karthik-k-bhat/Ultrasonic-Data-Transfer/Images/Dog_repellant_circuit_simulation.JPG

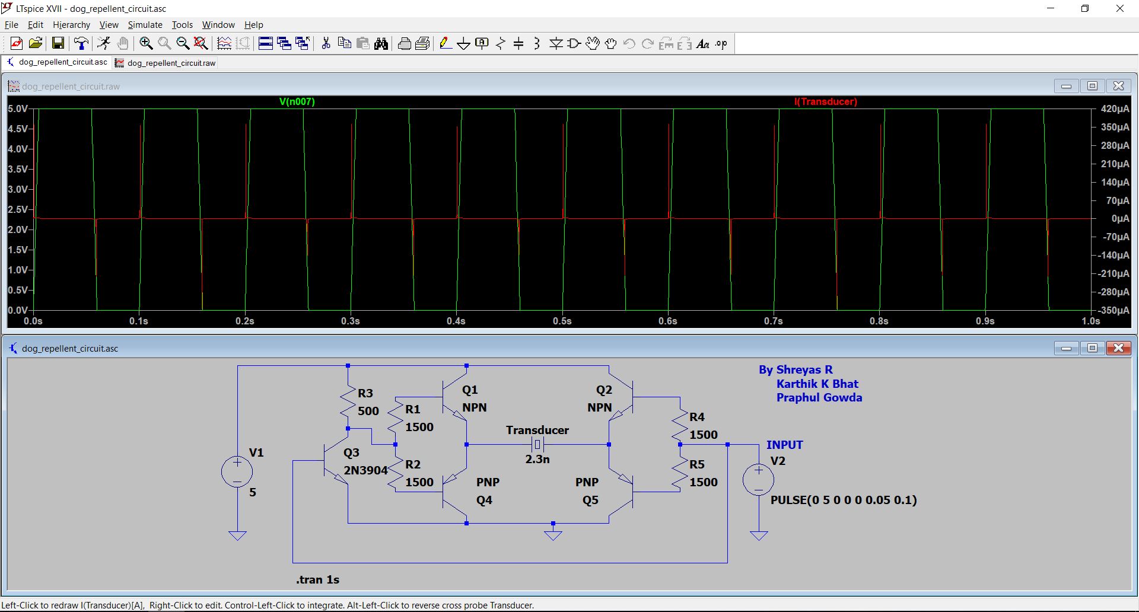
Images/Dog_repellant_circuit_simulation.JPG
