karthik-k-bhat/Ultrasonic-Data-Transfer/Images/HEIC/IMG_9461.jpg

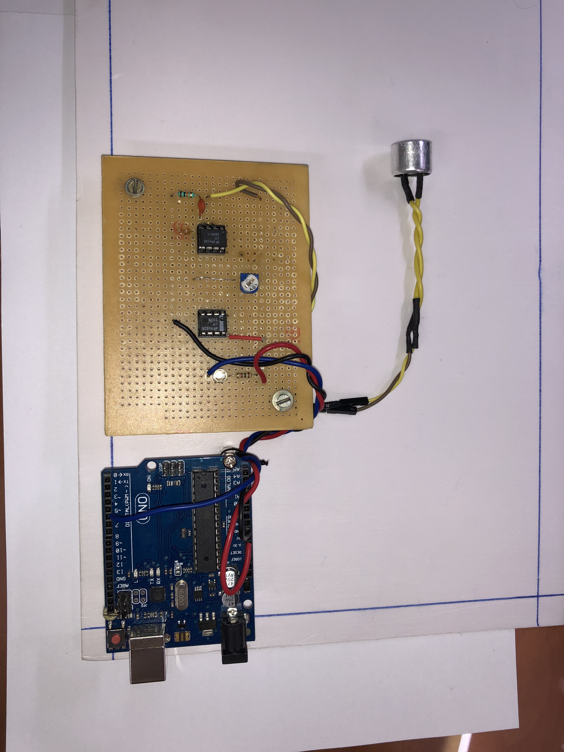
Images/HEIC/IMG_9461.jpg
