karthik-k-bhat/Ultrasonic-Data-Transfer/PESU_E&C_4th_Sem_data_transfer_with_ultrasonic v2.pptx

## Department of Electronics and Communication Engineering

Data Transmission through Ultrasonic Sound

By:
Shreyas R PES1201701714
Praphul Gowda PES1201700237
Karthik K Bhat PES1201701499

Guide:
Dr. Anuradha M
Mrs. Savithri K R
Ms. Shilpa Hosur

## Abstract

- Short-range connectivity among electronic devices is essential to build a connected world.
- With billions of connected devices, the need for devices to identify and communicate with each other is increasing.
- Radio Frequency based wireless communication rely on high power radio transmitters

## Introduction

- Data can be transmitted with standard speakers and microphones.
- Ultrasonic bypasses the physical limitation of short-range RF.
- Similar to other communication protocols, data can be encrypted and transmitted.
- Properties of sound enable quick localised data transfers which is key factor in sharing resources based on proximity.

## Problem Statement

Design a prototype that is able to transfer digital data using ultrasonic sound

# | Details | Value | Unit | Remark

1 | Transmission Length | 20 | centimetre | Maximum length
2 | Transmitter Power | TBD | Watt
3 | Power Supply | 5 | Volts
4 | Transmission Speed | 80 | bps
5
6

## Literature Survey

- The 18.5 to-20 kHz is inaudible to most humans and yet realizable with commodity speakers and microphones in mobile devices.
- Modulation is made in such a way that makes it robust to noise and reverberation in the environment.
- Speakers of common phone produces 74 dB SPL at 18 kHz whereas the threshold is 86 dB SPL to be audible.
- The range is reliable for a maximum distance ranging from 2 m to 10 m.

## Applications

- Ultrasonic data transmission can be used under-water.
- Short-range resource sharing between devices.
- Data transmission in places where electromagnetic radiations are harmful e.g. Petrol bunks, Healthcare

## Approach

Microcontroller

Ultrasonic Transmitter

Ultrasonic Receiver

Microcontroller

Data to be sent

Data received

## Transmitter Schematic

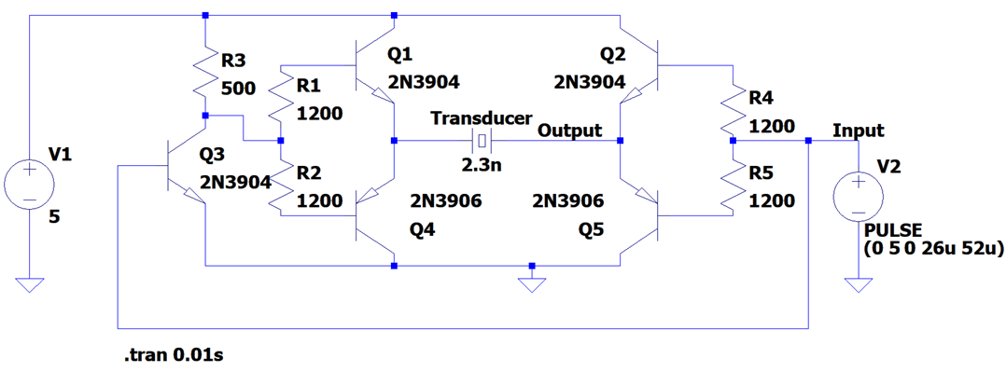
[picture p23: figure]

Notes: >> Uses PNP and NPN transistors to bring the current levels to an optimum range which is suitable for the ultrasonic transducers to operate.
>> The current levels varies with respect to the message signal.

## Transmitter Circuit Simulation

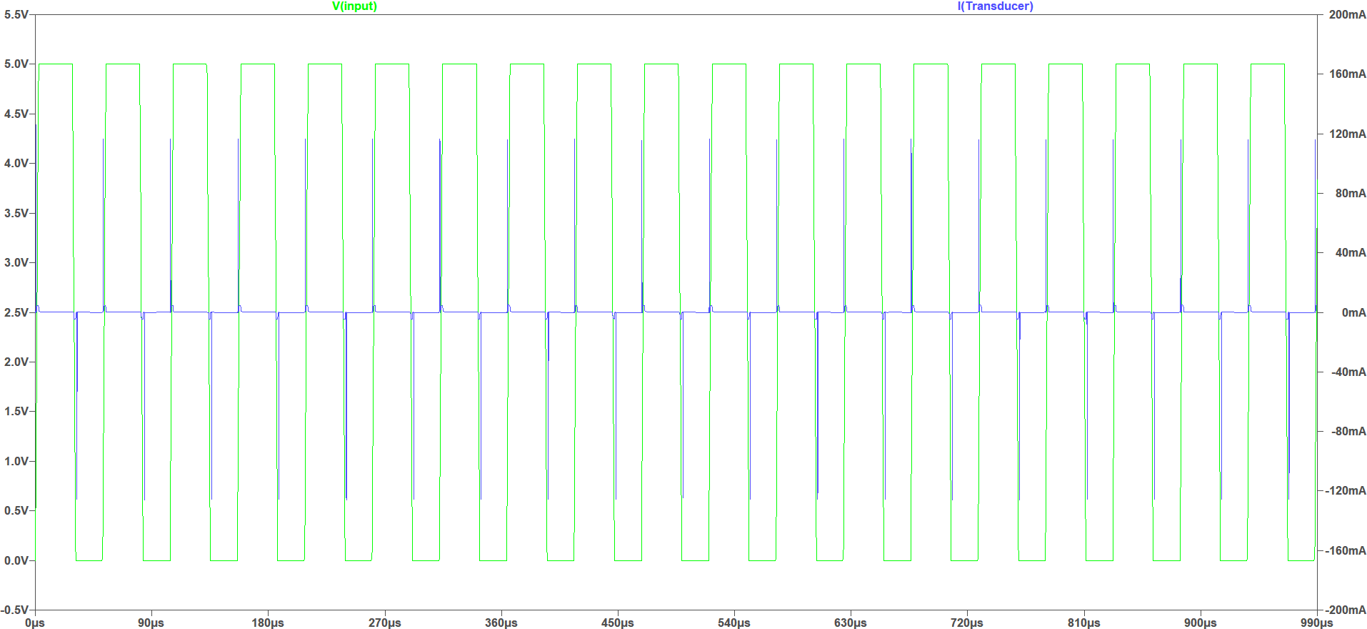
[picture p24: figure]

Simulation of Ultrasonic Transducer Driver Circuit on LTSpice software

## Receiver Schematic

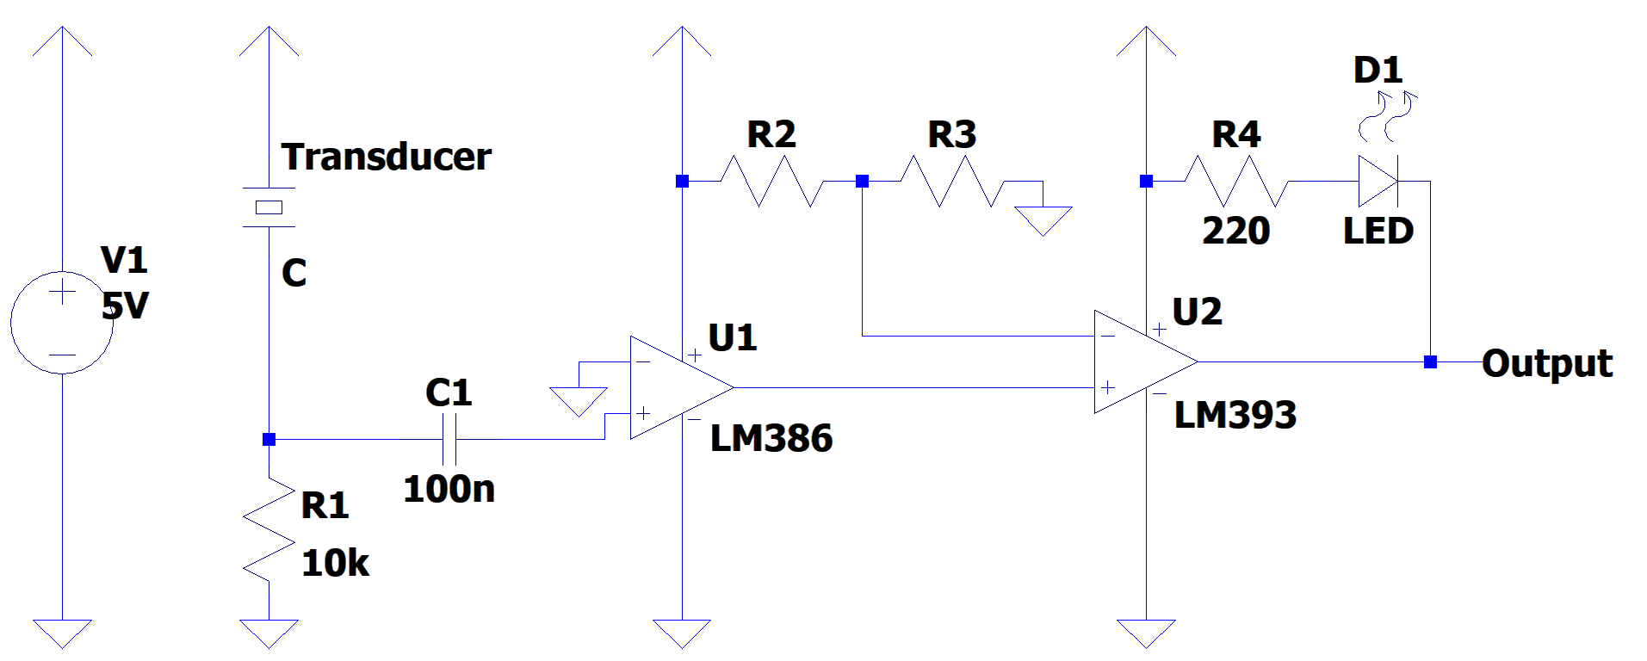
[picture p25: figure]

## Receiver Circuit Simulation

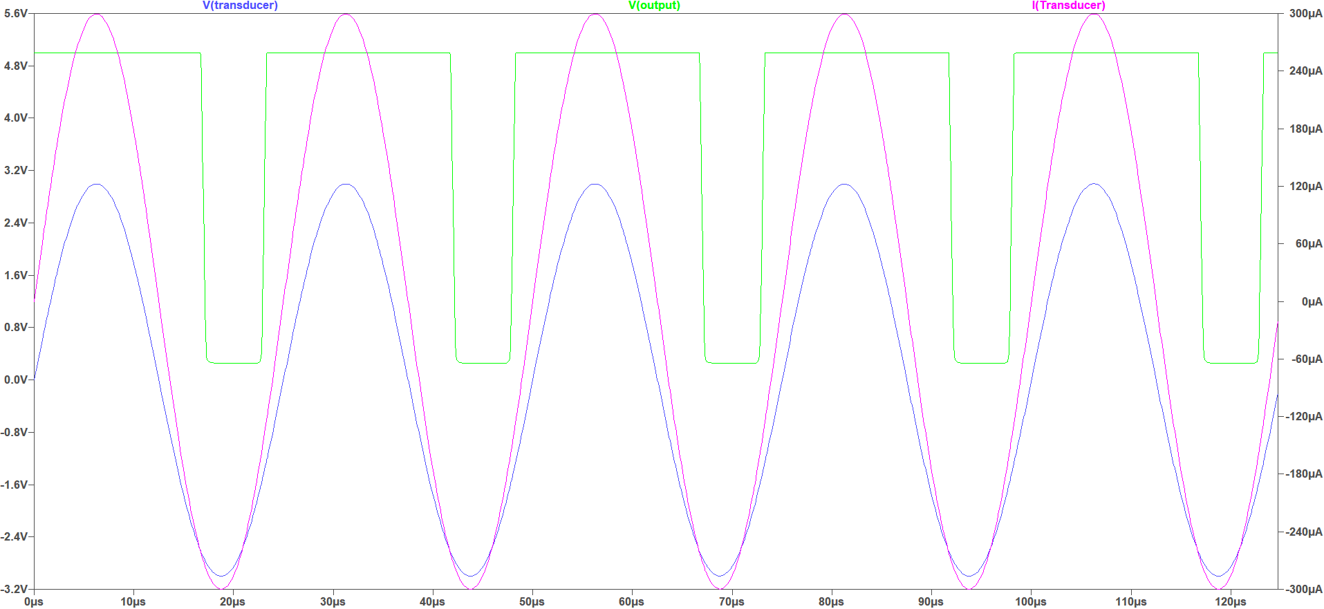
[picture p26: figure]

Simulation of Receiver Circuit on LTSpice software

Simulation of Receiver Circuit on LTSpice software

## Transmission Algorithm

1. A square wave of 40 kHz is used for transmission.
2. Denote the start of the transmission of a byte by sending the square wave for a duration of 10 milli-seconds.
3. Read individual bits of the data.
  - If the bit is 1, then send the square wave for 2 milli-seconds.
  - If the bit is 0, then send the square wave for 4 milli-seconds.
4. Wait for 10 milli-seconds before transmitting the next bit.

Notes: Tone() - Generates a square wave of the specified frequency on specified pin with 50% duty cycle

## Reception Algorithm

1. Find the maximum time of reception and minimum time of reception.
2. The minimum time of reception refers a high bit.
3. Twice the minimum time of reception refers a low bit.
4. Half the maximum time of reception refers to reception of next bit
5. The maximum time of reception refers to reception of a new byte.
6. Have some threshold for the reception time to accommodate small variation in the length of transmission.
7. Encode the time in terms of bits and read the characters.

## Developed Hardware

## Results

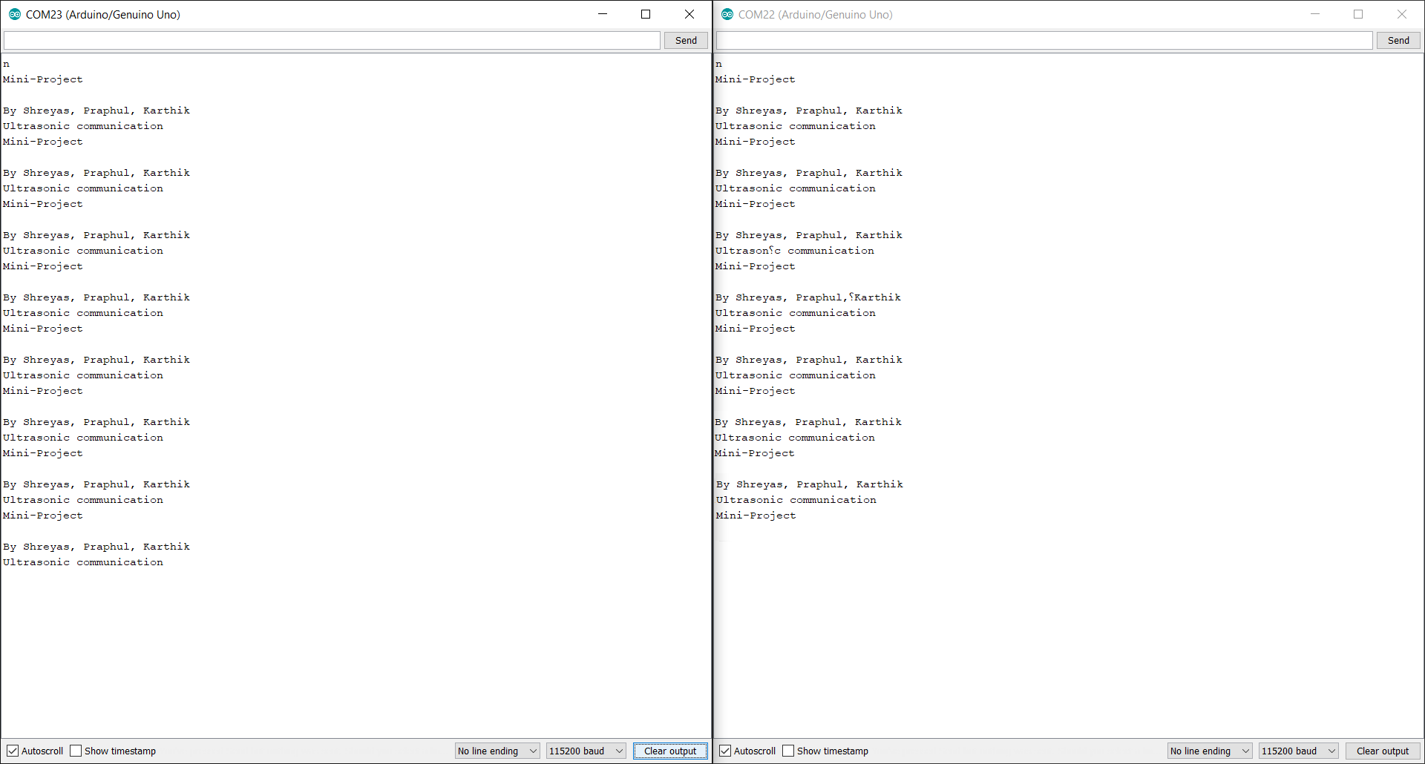
[picture p27: figure]

Simulation of Receiver Circuit on LTSpice software

Simulation of Receiver Circuit on LTSpice software

## Demo Video

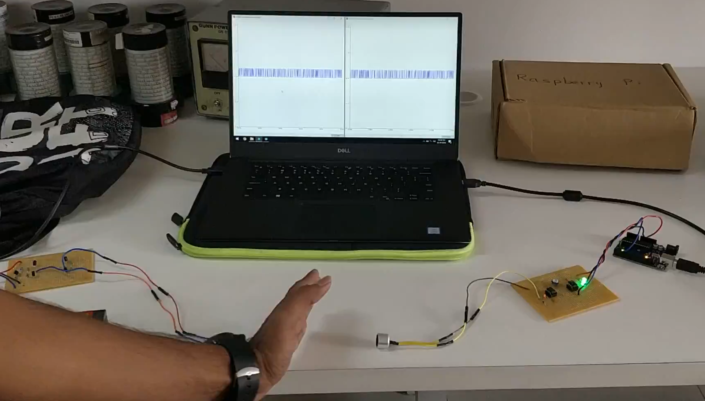
[picture p28: figure]

## Future Scope

- To improve the prototype for dynamic length of transmission
- Find better, efficient algorithm to increase the speed of transmission
- Interface with smartphones
  - To help in transfer of data in electromagnetic sensitive zones.
  - To help in pairing of devices

## Conclusion

- Successfully transmitted data using Ultrasonic sound.
- Our prototype works only when transmitter and receiver transducers are in line-of-sight.

## Progress Timeline

Week 1
Literature Survey
Week 2
Understand working of Transducer and HC-SR04
Week 3
Design and simulation of Transmitter circuit #1
Week 4
Week 5
Design and simulation of Transmitter circuit #2
Design and simulation of multiple receiver circuit
Week 6
Building and testing the transmitter circuit

## Progress Timeline

Week 7
Building and testing the receiver circuit
Week 8
Developing the algorithm and code for transmission
Week 9
Developing the algorithm and code for reception
Week 10
Week 11
Testing the hardware
Verifying the outputs
Week 12 & 13
Changes to hardware
Compiling the results
Attempt to find algorithm for dynamic length of transmission

## Literature

- https://lisnr.com/resources/blog/ultrasonic-data-transmission-compares-rf/
- https://ieeexplore.ieee.org/document/8080245
- http://www.kerrywong.com/2011/01/22/a-sensitive-diy-ultrasonic-range-sensor/
- http://www.pcserviceselectronics.co.uk/arduino/Ultrasonic/electronics.php

## References

kHz | Kilo Hertz
bps | bits per second
RF | Radio Frequency
dB | Decibels
dB SPL | Sound Pressure Level (1 Pascal is equal to SPL of 94 dB)
m | meter
SNR | Signal to Noise Ratio
GND | Ground

## Thank You
