karthik-k-bhat/Ultrasonic-Data-Transfer/HC-SR04-cct.png

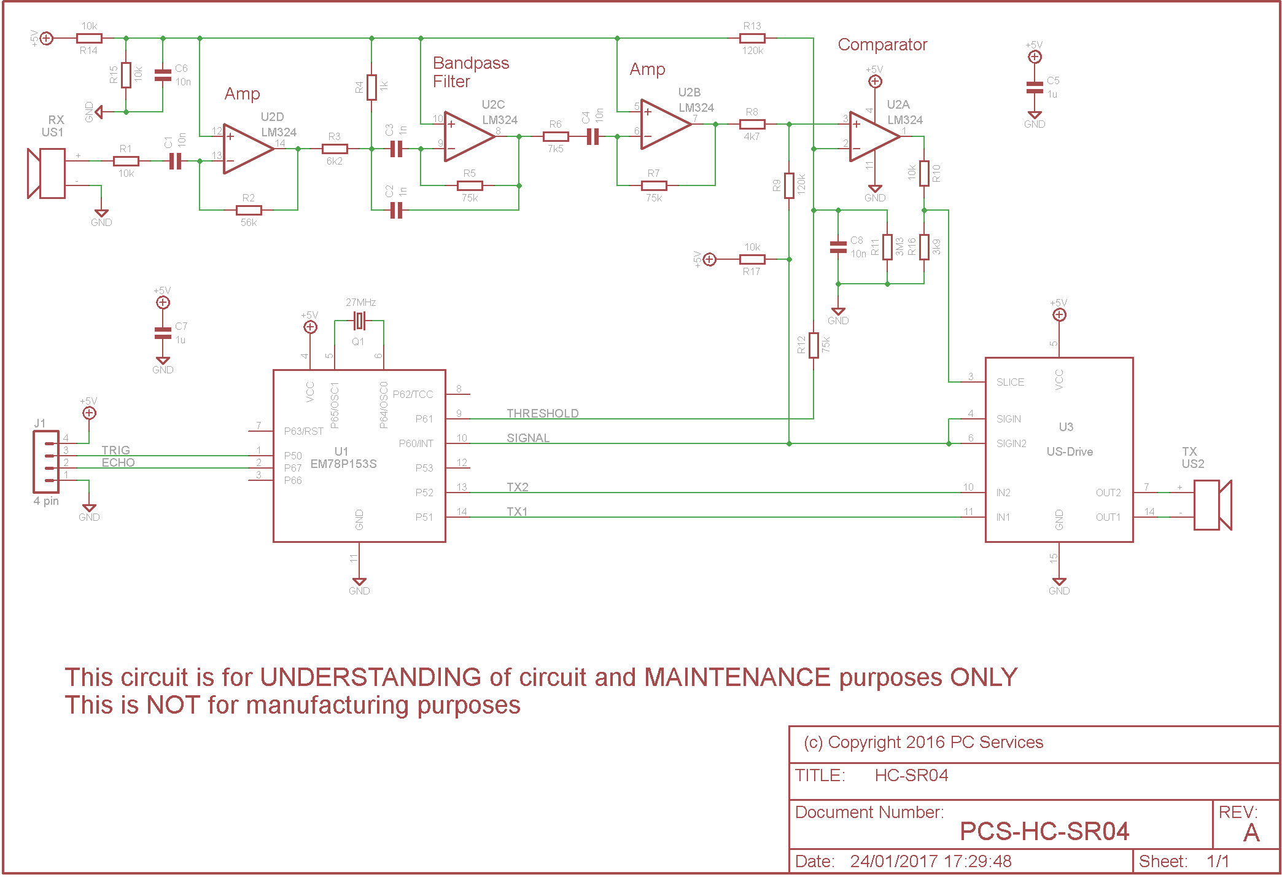
HC-SR04-cct.png
