karthik-k-bhat/Ultrasonic-Data-Transfer/Images/Amplitude_modulation_circuit_simulation.JPG

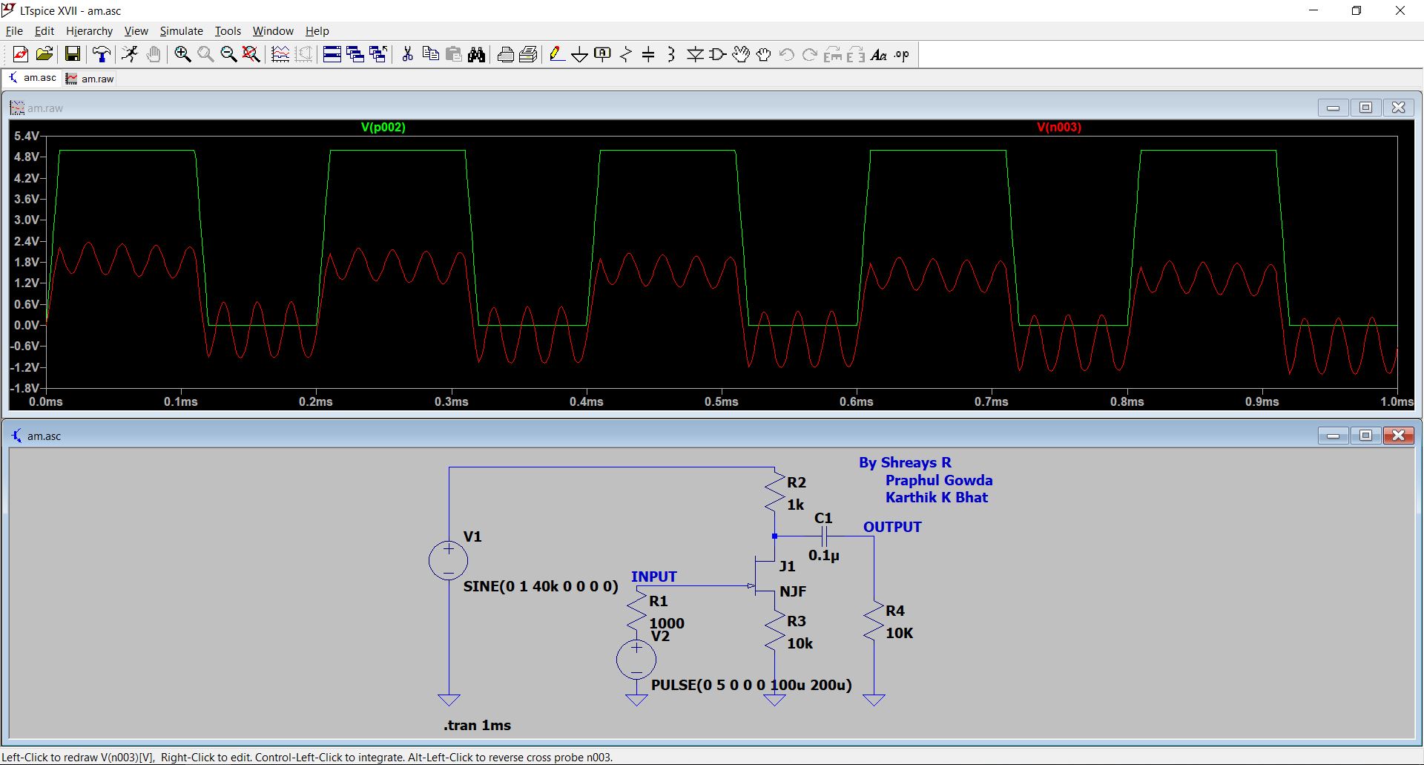
Images/Amplitude_modulation_circuit_simulation.JPG
