karthik-k-bhat/Ultrasonic-Data-Transfer/Images/Dog_repellant_circuit.JPG

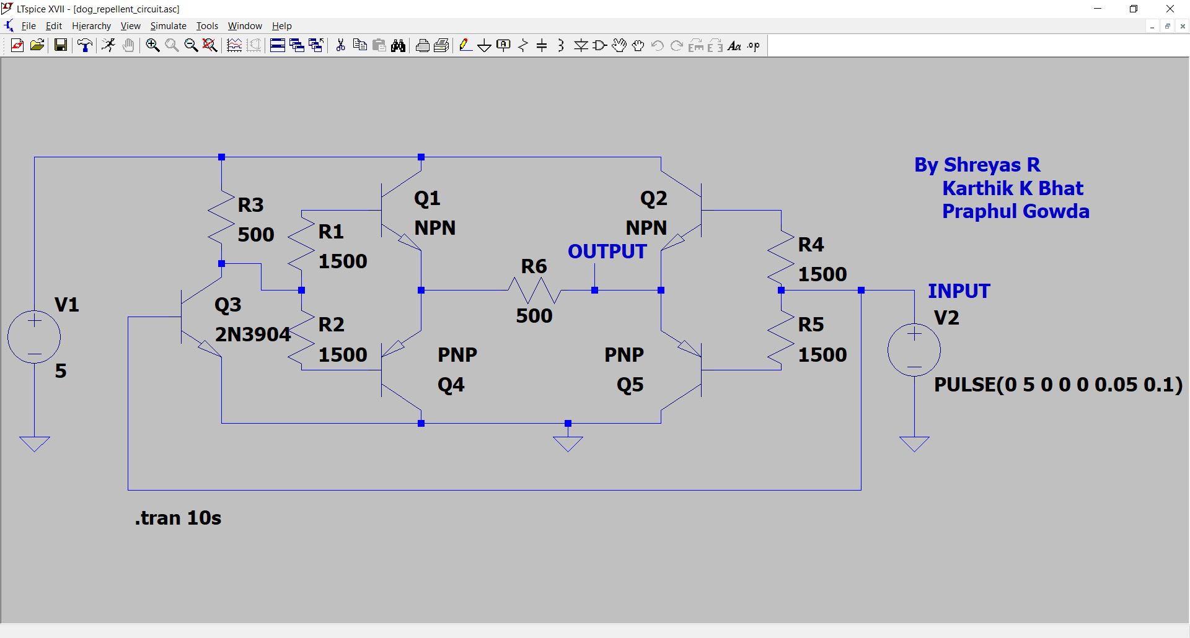
Images/Dog_repellant_circuit.JPG
