karthik-k-bhat/Ultrasonic-Data-Transfer/Images/HEIC/IMG_9458.jpg

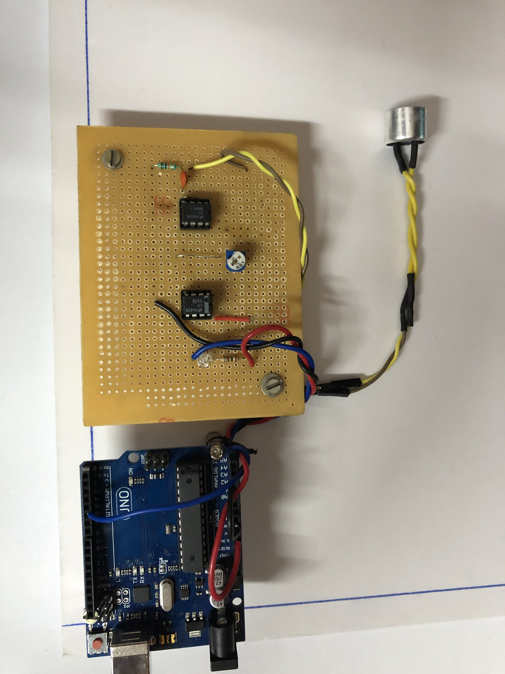
Images/HEIC/IMG_9458.jpg
