karthik-k-bhat/Ultrasonic-Data-Transfer/Images/HEIC/IMG_9459.jpg

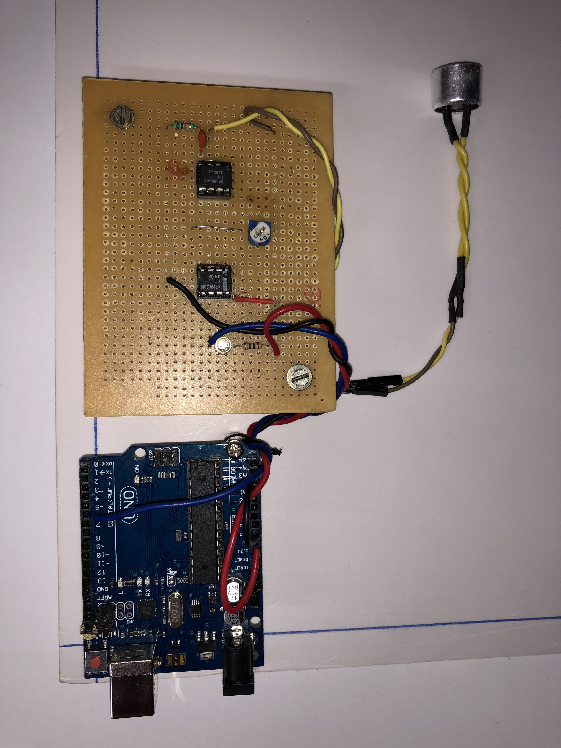
Images/HEIC/IMG_9459.jpg
