karthik-k-bhat/Ultrasonic-Data-Transfer/Images/HEIC/IMG_9460.jpg

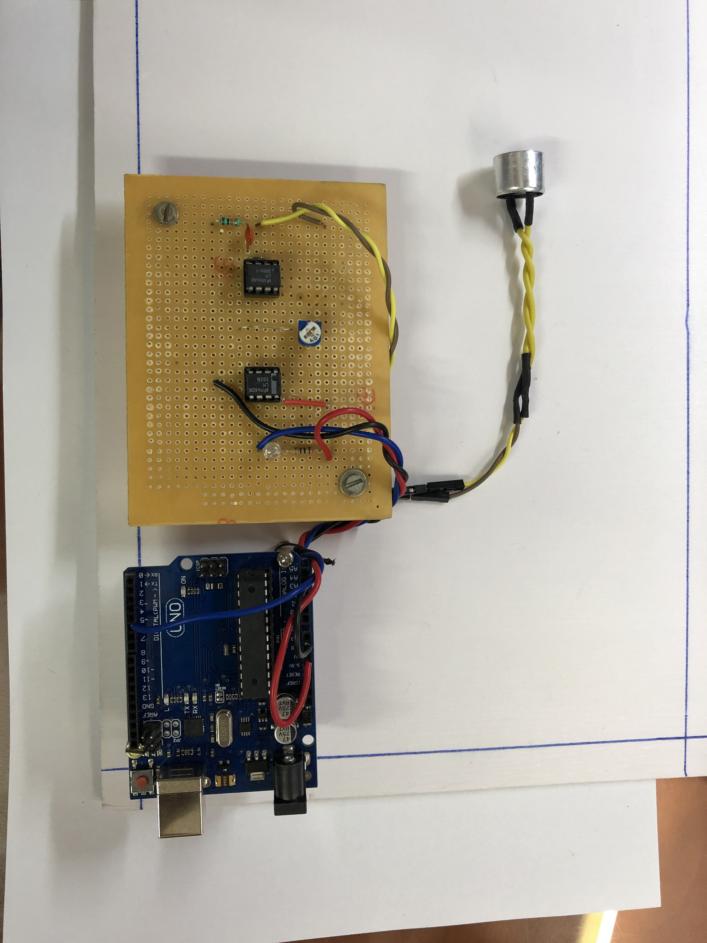
Images/HEIC/IMG_9460.jpg
