karthik-k-bhat/Ultrasonic-Data-Transfer/Images/HEIC/IMG_9462.jpg

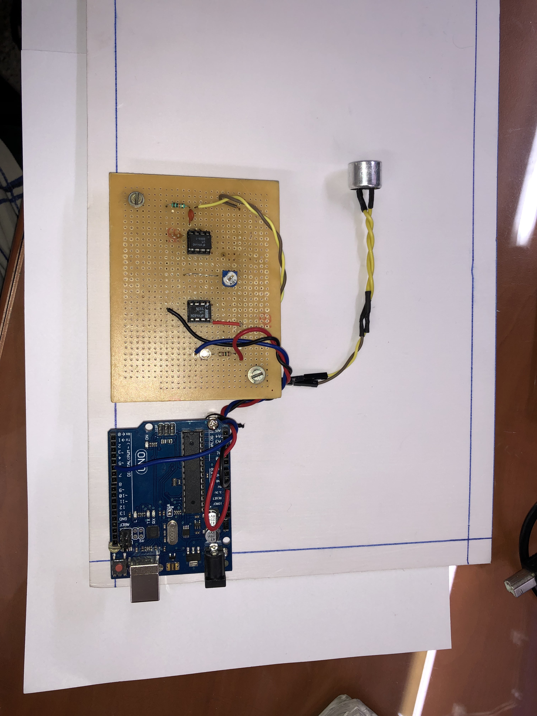
Images/HEIC/IMG_9462.jpg
