karthik-k-bhat/Ultrasonic-Data-Transfer/Images/HEIC/IMG_9464.jpg

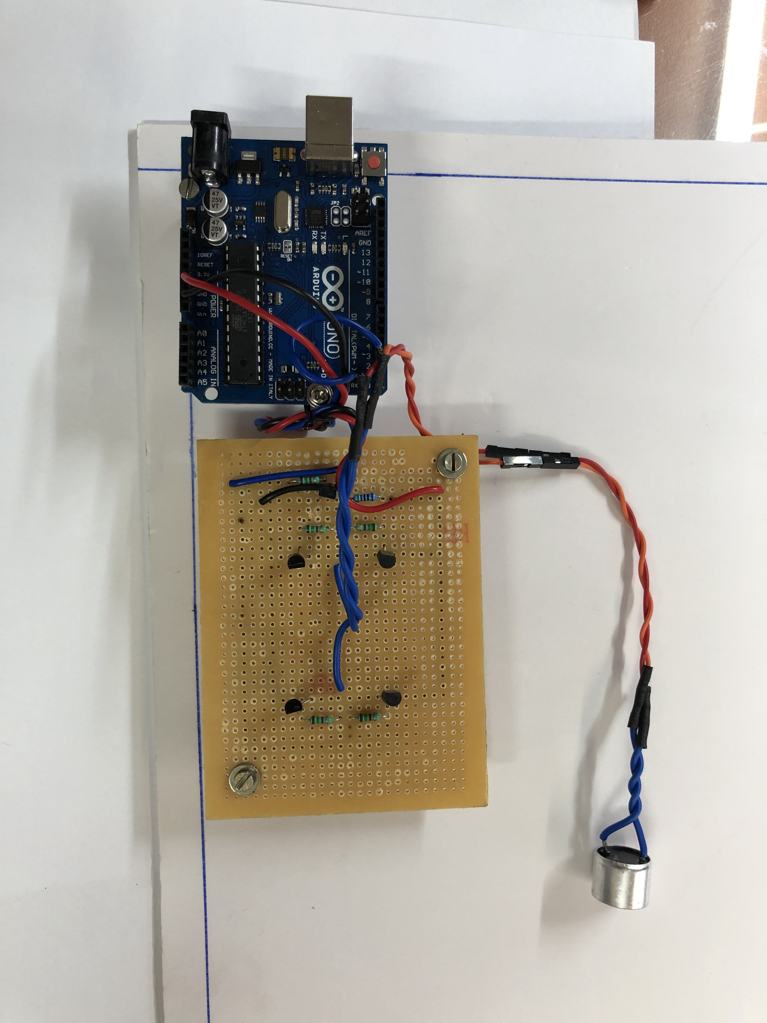
Images/HEIC/IMG_9464.jpg
