karthik-k-bhat/Ultrasonic-Data-Transfer/Images/HEIC/IMG_9465.jpg

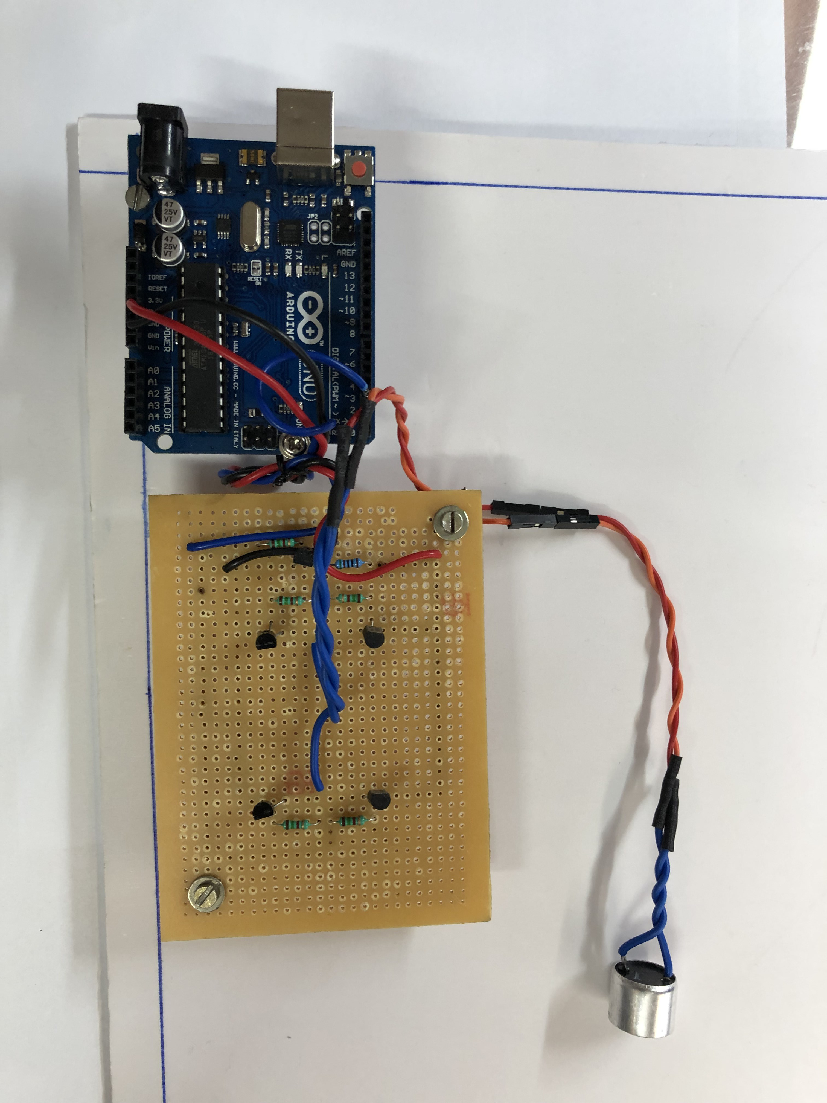
Images/HEIC/IMG_9465.jpg
