karthik-k-bhat/Ultrasonic-Data-Transfer/Images/HEIC/IMG_9467.jpg

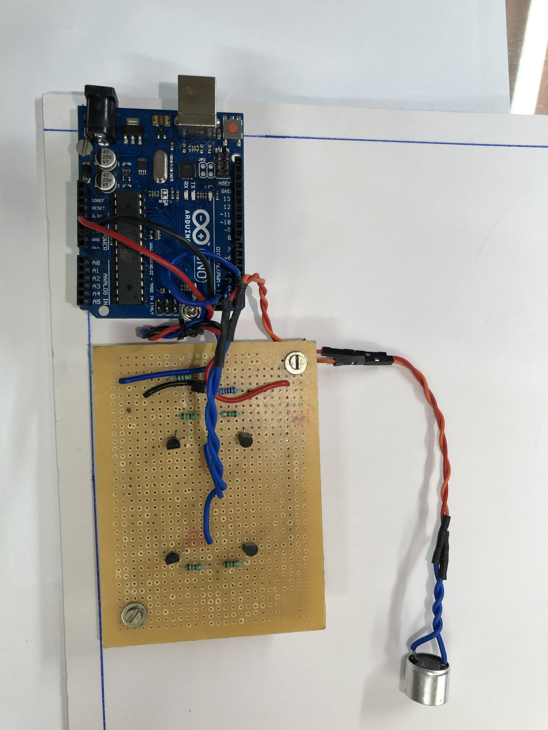
Images/HEIC/IMG_9467.jpg
