karthik-k-bhat/Ultrasonic-Data-Transfer/Documents/Stickers.pdf

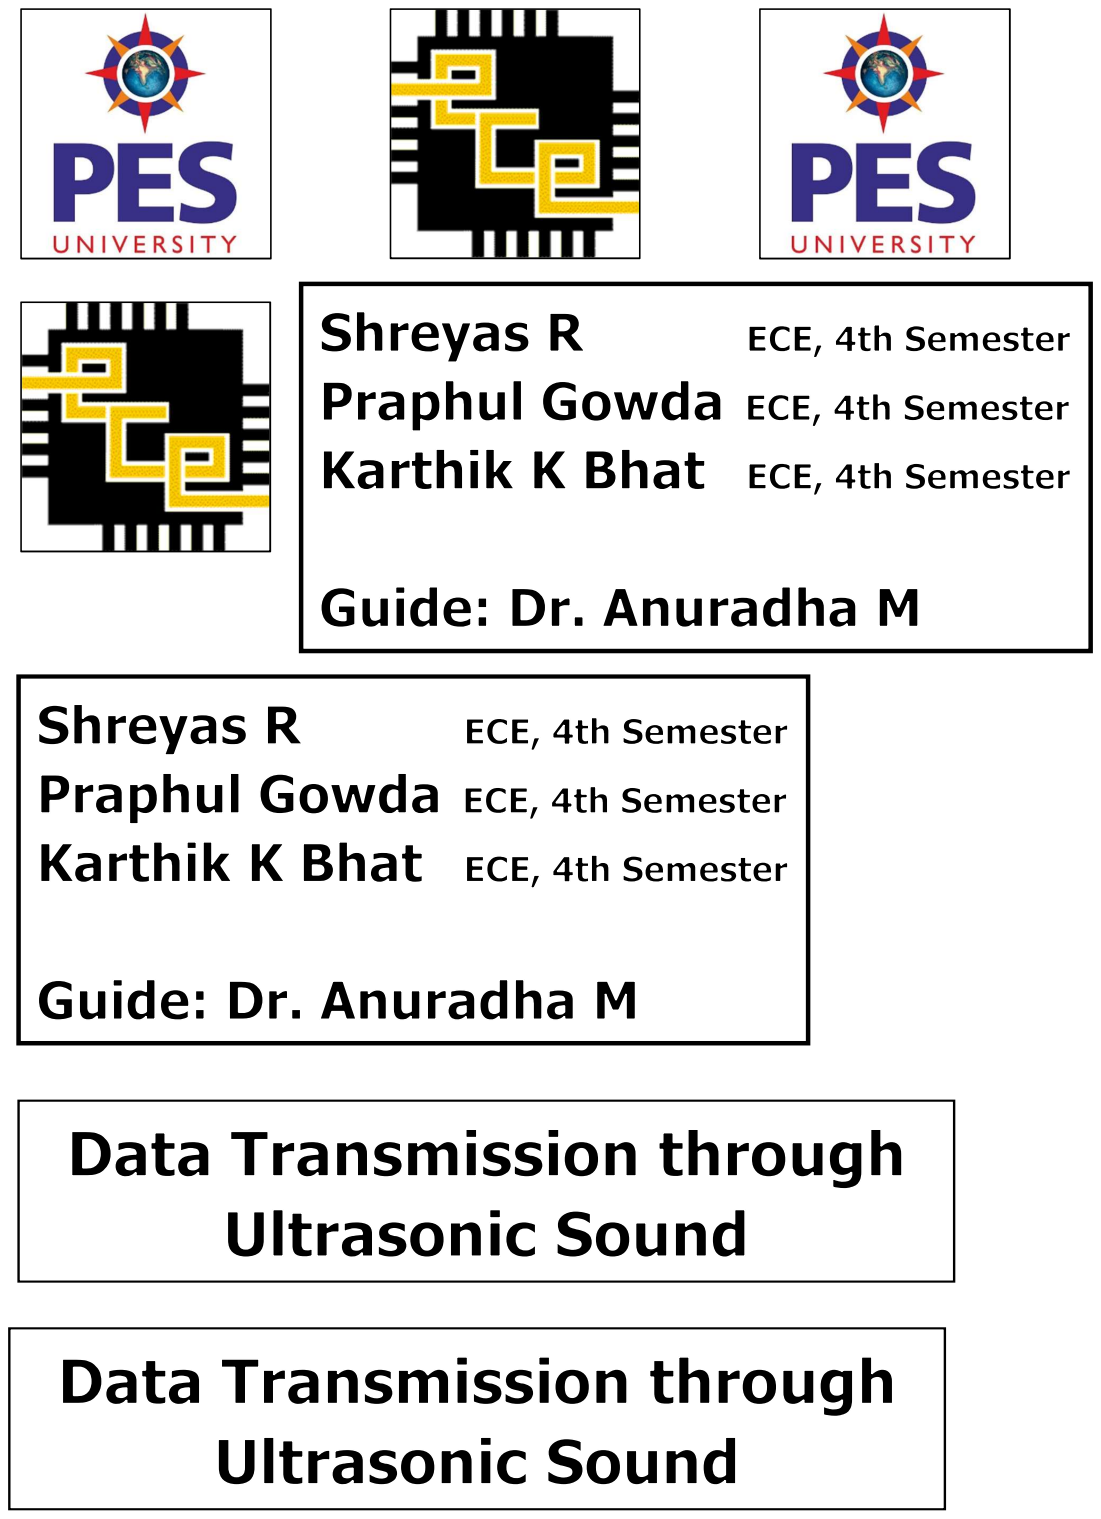
[picture p95: page 1]
