karthik-k-bhat/Ultrasonic-Data-Transfer/Simulations/Receiver Circuit.asc

C1: cap; 100n
D1: diode; 1N914
R1: res; 10k
R2: res; 5k
R3: res; 5k
R4: res; 220
Transducer: current; SINE(0 0.25m 40k)
U1: UniversalOpamp2
U2: UniversalOpamp2
V1: voltage; 5V
Named nets: COM, 0, Transducer, First_stage_Amplification, Second_stage_Amplification
.tran 125u
