karthik-k-bhat/Ultrasonic-Data-Transfer/Simulations/dog_repellent_circuit.asc

Q1: npn; 2N3904
Q2: npn; 2N3904
Q3: npn; 2N3904
Q4: pnp; 2N3906
Q5: pnp; 2N3906
R1: res; 1200
R2: res; 1200
R3: res; 500
R4: res; 1200
R5: res; 1200
Transducer: xtal; 2.3n
V1: voltage; 5
V2: voltage; PULSE(0 5 0 0 0 26u 52u)
Named nets: 0, Input, Output
.tran 0.01s
By Shreyas R
      Praphul Gowda
      Karthik K Bhat
