karthik-k-bhat/Ultrasonic-Data-Transfer/Simulations/am.asc

C1: cap; 0.1µ
J1: njf
R1: res; 1000
R2: res; 1k
R3: res; 10k
R4: res; 10K
V1: voltage; SINE(0 1 40k 0 0 0 0)
V2: voltage; PULSE(0 5 0 0 0 100u 200u)
Named nets: 0
.tran 1ms
INPUT
OUTPUT
By Shreays R
      Praphul Gowda
      Karthik K Bhat
