karthik-k-bhat/Ultrasonic-Data-Transfer/Simulations/transmitter_circuit2.asc

C1: cap; 0.1µ
C2: cap; 0.1µ
C3: xtal; 1µ; V=16 Irms=0 Rser=11 Lser=0 mfg="AVX" pn="TAJA105K016" type="Tantalum"
Q1: npn; BC547C
R1: res; 100k
R2: res; 470k
R3: res; 1k
R4: res; 1k
V1: voltage; 5V
V2: voltage; PULSE(0 5 0 0 0 12.5u 25u)
V3: voltage; SINE(2.5 2.5 36800 0 0)
Named nets: 0
.tran 0 0.005 0.003
