karthik-k-bhat/Ultrasonic-Data-Transfer/(commit log)

2019-04-26 Circuit simulations done
2019-04-26 Update Presentation
    Need to change Abstract, Literature Survey, Introduction and references.
    Need to make the flowchart
2019-04-26 transmitter flowchart
2019-04-27 Update Report-mini-project.docx
    updated receiver circuit.
